UltimateHackingKeyboard/uhk60v1-electronics/display/display.kicad_pcb

## KiCad design display/display.kicad_pcb (2017-12-09)

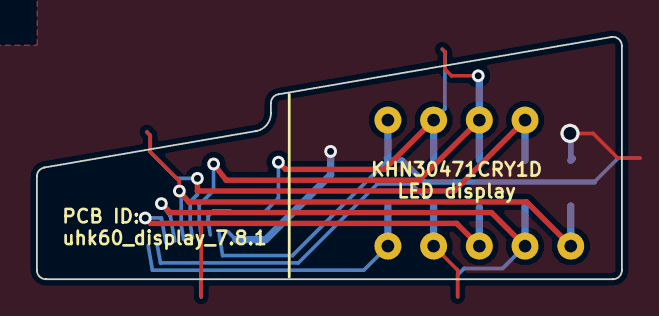
[picture p1: board display.kicad_pcb from above]

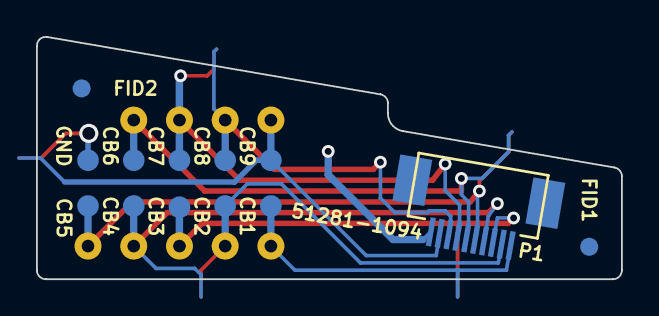
[picture p2: board display.kicad_pcb from below]

Board: 2 copper layers, 32.5 x 13.5 mm, 14 parts (13 on the bottom side), 10 nets.

Parts:
FID1, FID2: FIDUCIAL; FID
P1: 51281-1094; FFC_Connector_51281-1094
P2: CONN_9; UHK_LED_display
TP_CB1: CB1; Test_Point
TP_CB2: CB2; Test_Point
TP_CB3: CB3; Test_Point
TP_CB4: CB4; Test_Point
TP_CB5: CB5; Test_Point
TP_CB6: CB6; Test_Point
TP_CB7: CB7; Test_Point
TP_CB8: CB8; Test_Point
TP_CB9: CB9; Test_Point
TP_GND1: GND; Test_Point

Connections:
/CB1: P1.1, P2.1, TP_CB1.1
/CB2: P1.2, P2.2, TP_CB2.1
/CB3: P1.3, P2.3, TP_CB3.1
/CB4: P1.4, P2.4, TP_CB4.1
/CB5: P1.5, P2.5, TP_CB5.1
/CB6: P1.6, P2.6, TP_CB6.1
/CB7: P1.7, P2.7, TP_CB7.1
/CB8: P1.8, P2.8, TP_CB8.1
/CB9: P1.9, P2.9, TP_CB9.1
GND: P1.10, TP_GND1.1
