UltimateHackingKeyboard/uhk60v1-electronics/connectors/connectors.kicad_pcb

## KiCad design connectors/connectors.kicad_pcb (2017-12-07)

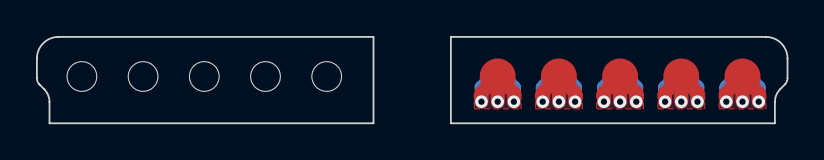
[picture p7: board connectors.kicad_pcb from above]

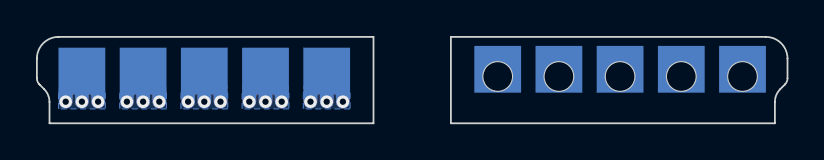
[picture p8: board connectors.kicad_pcb from below]

Board: 2 copper layers, 41.7 x 4.8 mm, 10 parts (5 on the bottom side), 5 nets.

Parts:
P11, P12, P13, P14, P15: CONN_1; UHK_Connector_Right_Outer_Pad
P21, P22, P23, P24, P25: CONN_1; UHK_Connector_Right_Inner_Pad

Connections:
unnamed: P11.1, P21.1
unnamed: P12.1, P22.1
unnamed: P13.1, P23.1
unnamed: P14.1, P24.1
unnamed: P15.1, P25.1
